Letadliko/pwm_generator/doc/obrazky/20261104_141640.jpg

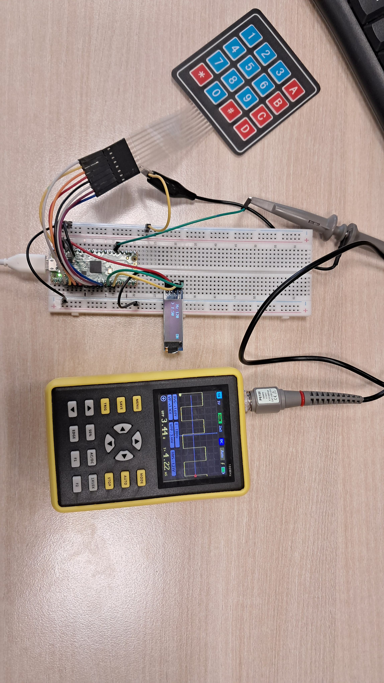
doc/obrazky/20261104_141640.jpg
