Letadliko/pwm_generator/doc/obrazky/20261104_141718.jpg

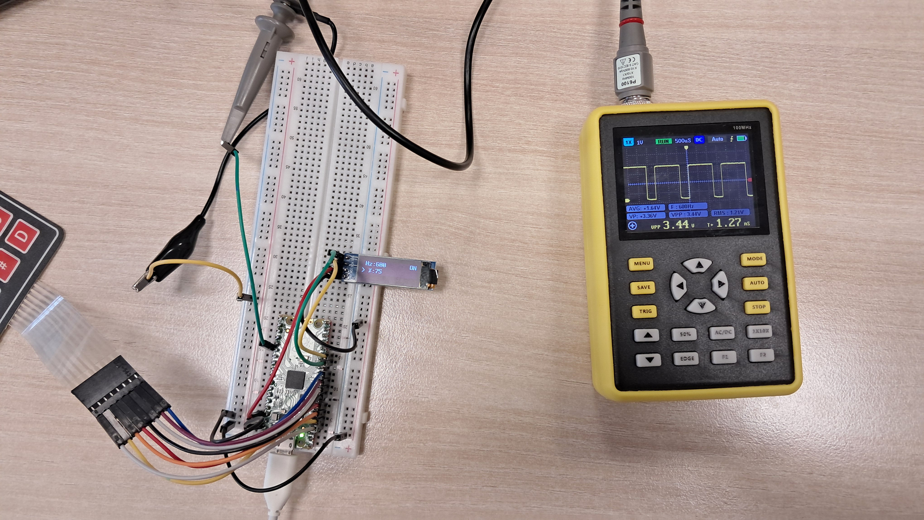
doc/obrazky/20261104_141718.jpg
