Letadliko/pwm_generator/doc/obrazky/prubehy_pwm.png

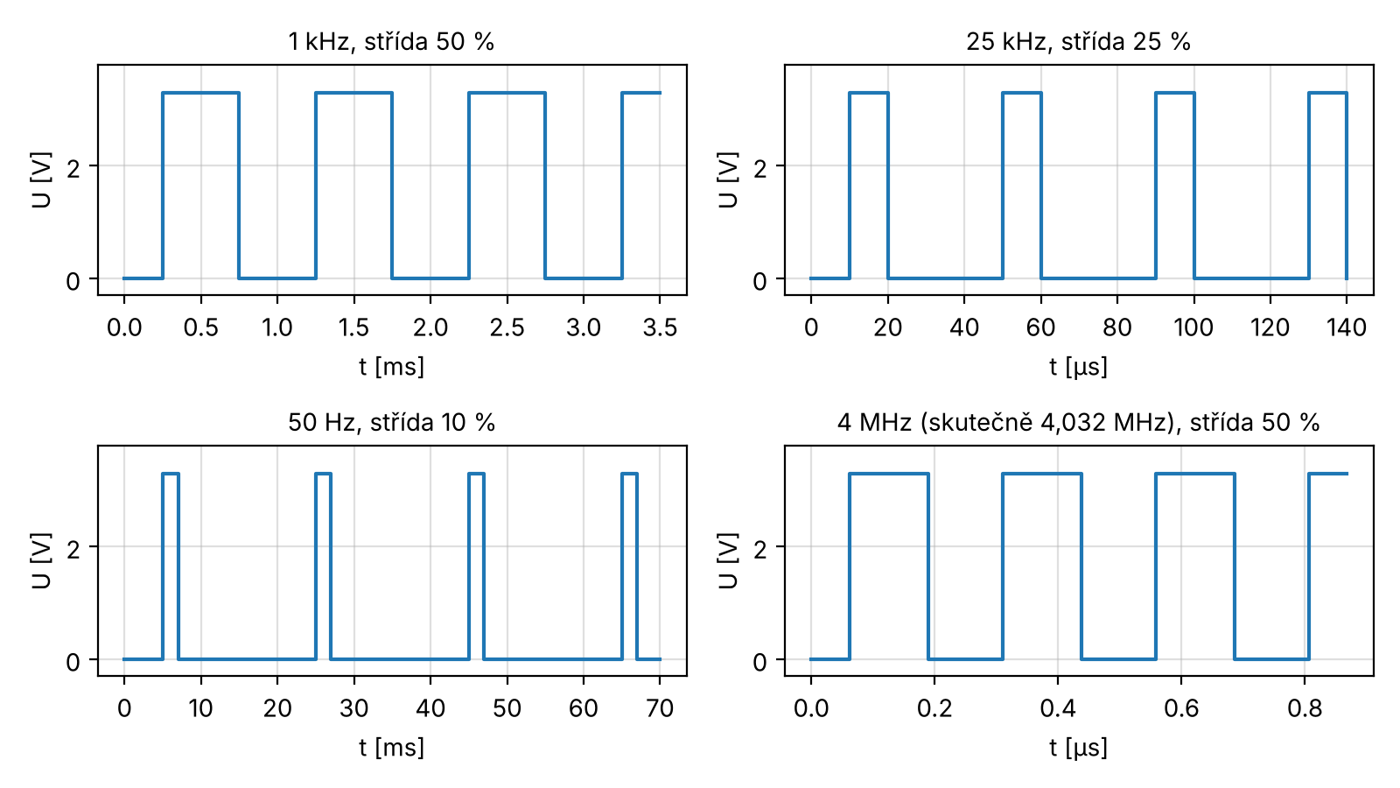
doc/obrazky/prubehy_pwm.png
