Letadliko/pwm_generator/schema/pwm_generator.kicad_sch

## KiCad design schema/pwm_generator.kicad_sch (2026-11-04)

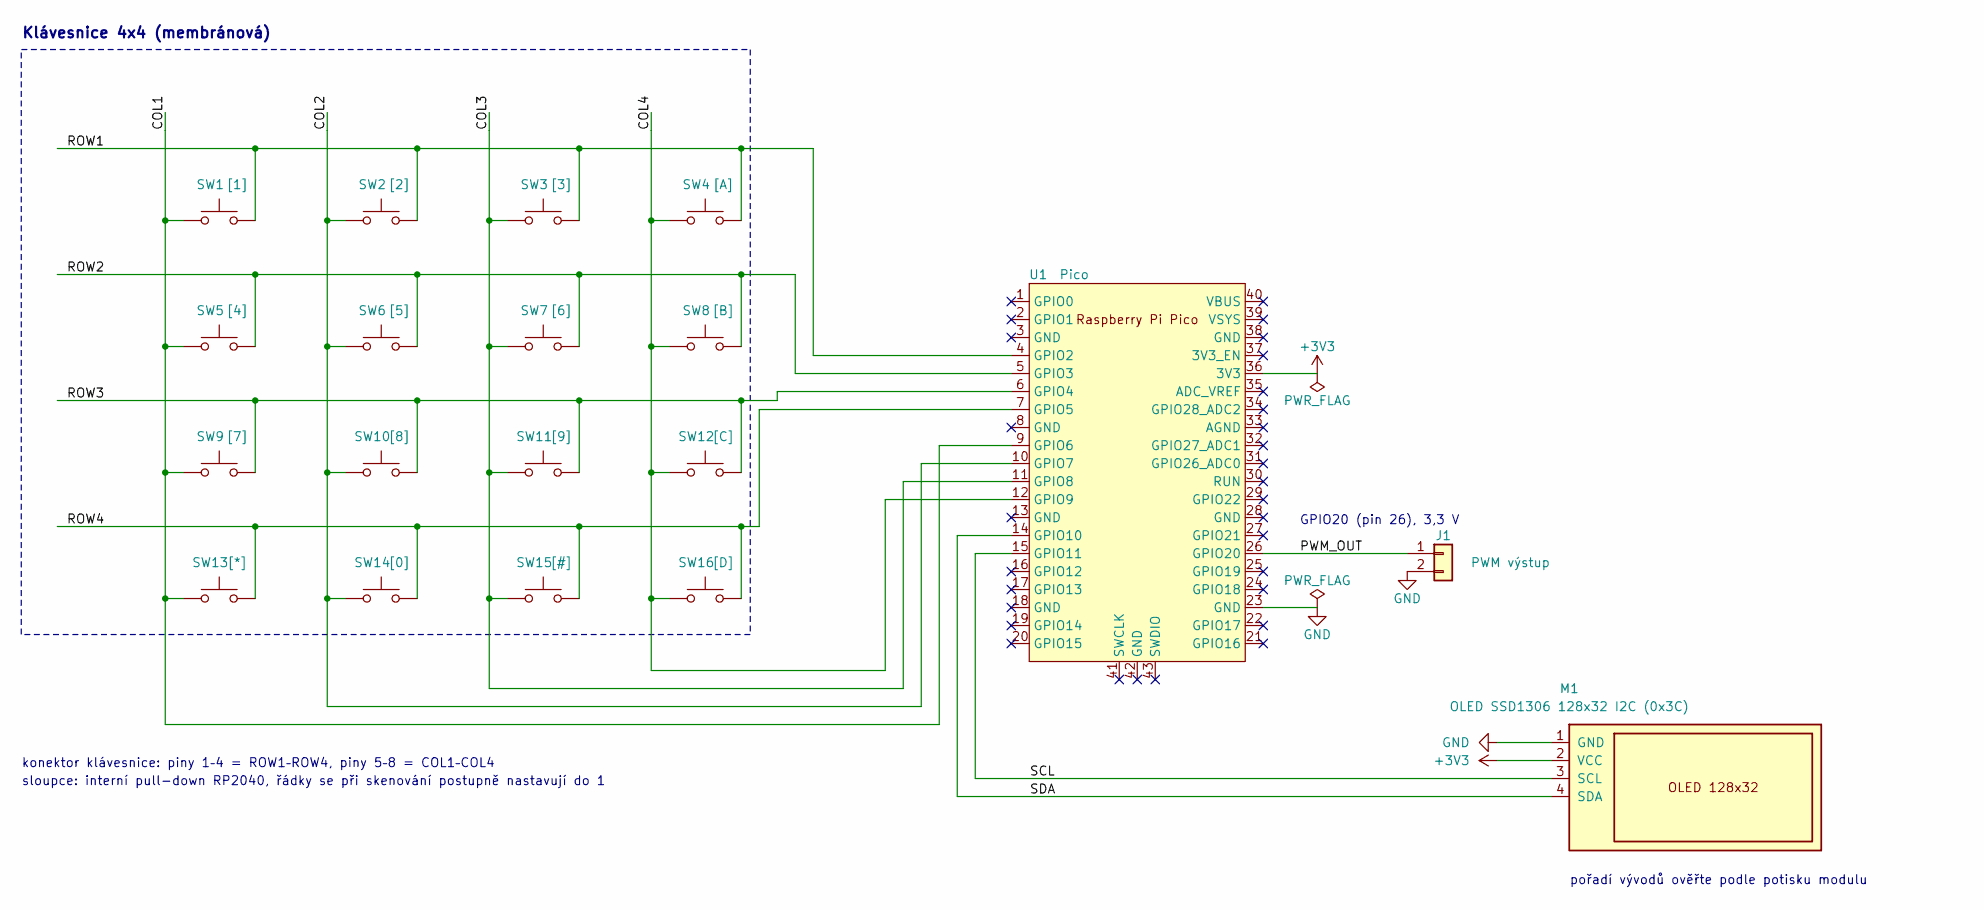
[picture p8: schematic pwm_generator.kicad_sch]

Parts:
J1: PWM výstup
M1: OLED SSD1306 128x32 I2C (0x3C)
SW1: [1]
SW2: [2]
SW3: [3]
SW4: [A]
SW5: [4]
SW6: [5]
SW7: [6]
SW8: [B]
SW9: [7]
SW10: [8]
SW11: [9]
SW12: [C]
SW13: [*]
SW14: [0]
SW15: [#]
SW16: [D]
U1: Pico; RPi_Pico_SMD_TH

Connections:
+3V3: M1.2 (VCC), U1.36 (3V3)
COL1: SW1.1, SW5.1, SW9.1, SW13.1, U1.9 (GPIO6)
COL2: SW2.1, SW6.1, SW10.1, SW14.1, U1.10 (GPIO7)
COL3: SW3.1, SW7.1, SW11.1, SW15.1, U1.11 (GPIO8)
COL4: SW4.1, SW8.1, SW12.1, SW16.1, U1.12 (GPIO9)
GND: J1.2, M1.1 (GND), U1.23 (GND)
PWM_OUT: J1.1, U1.26 (GPIO20)
ROW1: SW1.2, SW2.2, SW3.2, SW4.2, U1.4 (GPIO2)
ROW2: SW5.2, SW6.2, SW7.2, SW8.2, U1.5 (GPIO3)
ROW3: SW9.2, SW10.2, SW11.2, SW12.2, U1.6 (GPIO4)
ROW4: SW13.2, SW14.2, SW15.2, SW16.2, U1.7 (GPIO5)
SCL: M1.3 (SCL), U1.15 (GPIO11)
SDA: M1.4 (SDA), U1.14 (GPIO10)

Notes on the sheet:
Klávesnice 4x4 (membránová)
konektor klávesnice: piny 1–4 = ROW1–ROW4, piny 5–8 = COL1–COL4
sloupce: interní pull-down RP2040, řádky se při skenování postupně nastavují do 1
pořadí vývodů ověřte podle potisku modulu
GPIO20 (pin 26), 3,3 V
